kimconcillado/BeagleBone-CAN-Backpack/README.md

BeagleBone-CAN-Backpack
=======================

The BeagleBone CAN backpack plugs into a BeagleBone and provides a CAN transceiver and +12V power.
