kimconcillado/BeagleBone-CAN-Backpack/Beaglebone CAN Cape BOM.xlsx

Qty | Description | Category | Manufacturer | Manufacturer Part | Vendor | Vendor Part | Cost | Designator
1 | Header, .1", 2-row, 72-pos, breakable (Short Pins) | Connectors | TE Connectivity | 3-826925-6 | DK | A106443-ND | 5.23 | X3
1 | Micro-Fit header, 6pos, RA, through-hole, with metal retaining clip | Connectors | Molex | 43045-0621 | DK | WM2674-ND | 1.8 | X-343
1 | Header, Female socket, .1"", 1-row, 6-pos | Connectors | TE Connectivity | 534237-4 | DK | A26418-ND | 1.42 | SV1
4 | P-Channel Enhancement Mode Field-Effect Transistor, -0.13 A, -50 V, SOT-23 | Semiconductors | Fairchild Semiconductor | BSS84 | NW | 58K8770 | 0.03 | Q2, Q3, Q6, Q7
3 | Resistor, 4.7k ohm 1%, 100 mW, 100ppm, 0603 | Passives | Panasonic | ERJ-3EKF4701V | DK | P4.70KHCT-ND | 0.1 | R5, R6, R7
4 | N-channel MOSFET, 25V, 220 mA, SOT-23 | Semiconductors | Fairchild Semiconductor | FDV301N | NW | 58K8856 | 0.03 | Q9, Q10, Q11, Q12
1 | Capacitor, Ceramic, 10 uF 16V, 10%, X5R, 0805 | Passives | Murata | GRM21BR61C106KE15L | NW | 35R0687 | 0.2 | C11
1 | Resistor, 1k ohm 63 mW, 1%, 0603 | Passives | Multicomp | MC0603WGF1001T5E-TC | NW | 58K4448 | 500 | R13
2 | Capacitor, Ceramic, 22 uF, 6.3V, X5R, 20%, 0805 | 22 uF | Murata | GRM21BR60J226ME39L | NW | 24R6338 | 0.091 | C3, C4
1 | Connector, USB, MiniB. SMT RT | Connectors | TE Connectivity | 1734035-2 | DK | A31727CT-ND | 0.872 | X2
2 | Molex Dura-Clik Header, 2pos, Vertical, SMT | Connectors | Molex | 560020-0220 | DK | WM10862CT-ND | 0.82 | X-521, X-520
2 | Molex Dura-Clik header, 3pos, vertical, SMT | Connectors | Molex | 560020-0320 | DK | WM10863CT-ND | 0.91 | X-518, X-519
1 | IC, Memory, I2CEEPROM, SOIC-8 | ICs | ON Semiconductor | CAT24C256WI-GT3 | DK | CAT24C256WI-GT3OSCT-ND | 0.803 | CAT24C256WI-GT3
1 | IC, USB Serial, SSOP-28 | ICs | FTDI | FT232RL | DK | 768-1007-1-ND | 7.68 | IC3
1 | IC, DC-DC Conv, Buck, 42 Vin, 1.25 MHz, SOT23-6 | ICs | Texas Instruments | LMR14206XMKE/NOPB | NW | 76T5004 | 2.72 | IC1
1 | IC, LDO VOLT REG, 3.3V, 0.5A, SOT-223-5 | ICs | Texas Instruments | LP38693MP-3.3/NOPB | NW | 41K7496 | 1.53 | IC2
1 | IC, CAN TX/RX, 1 MBps, 5.5V, 8-SOIC | ICs | Texas Instruments | SN65HVD1050D | NW | 70K4439 | 1.32 | IC8
1 | Schottky rectifier, 30V, 1A, SMA | Passives | Diodes Inc | B130-13-F | DK | B130-FDICT-ND | 0.43 | D1
6 | Capacitor, Ceramic, .1uF 25V 10% 0603 X7R | Passives | TDK | C1608X7R1E104K080AA | DK | 445-1316-1-ND | 0.011 | C50, C2, C7, C8, C9, C10
1 | Choke, common mode, 100 uH, 500 mA, 25% | Passives | Bourns Inc | DR331-104AE | NW | 29T3649 | 0.32 | L6
1 | Resistor, 1 kohm 100 mW, 1%, Thick Film, 0603 | Passives | Panasonic | ERJ-3EKF1001V | NW | 64R5308 | 0.012 | R4
3 | Resistor, 5.6 kohm, 100 mW, 1%, 0603 | Passives | Panasonic | ERJ-3EKF5601V | NW | 64R5354 | 0.096 | R3, R8, R9
2 | Resistor, 60.4 ohm, 100 mW, 1%, 0603 | Passives | Panasonic | ERJ-3EKF60R4V | NW | 65T8495 | 0.096 | R38, R43
1 | Capacitor, Ceramic, 4.7 nF, 50V, X7R, 10%, 0603 | Passives | Murata | GRM188R71H472KA01D | NW | 38K1673 | 0.006 | C51
1 | Capacitor, Ceramic, 10UF, 35V, X5R, 10%, 1206 | Passives | Murata | GRM31CR6YA106KA12L | NW | 72R4211 | 0.355 | C6
1 | Capacitor, Ceramic, 1 uF, 50V, X7R, 10%, 1210 | Passives | Murata | GRM32RR71H105KA01L | NW | 97K0677 | 0.248 | C1
1 | Capacitor, Ceramic, 4.7 uF 25V, 10%, X5R, 0805 | Passives | Multicomp | MC0805X475K250CT | NW | 06R4181 | 0.037 | C5
1 | Diode, Zener, 3 V, 200 mW, SOD-323 | Passives | ON Semiconductor | MM3Z3V0T1G | NW | 09R9502 | 0.017 | D29
1 | Resistor, 36 kohm, 1%, 100 mW, 0603 | Passives | Yageo | RC0603FR-0736KL | DK | 311-36.0KHRCT-ND | 0.0108 | R19
9 | Resistor, 10k ohm 100 mW, 5%, 100ppm, 0603 | Passives | Yageo | RC0603JR-1010KL | NW | 68R0215 | 0.008 | R1, R2, R12, R14, R15, R16, R17, R18, R20
1 | Inductor, 18 uH, 1.5 A, unshielded, 15%, 8012 | Passives | Bourns | SDR0604-180YL | DK | SDR0604-180YLCT-ND | 0.47 | L1
2 | TVS DIODE 30VWM 48.4VC SMB | Passives | Littelfuse | SMBJ30CA | DK | SMBJ30CALFCT-ND | 0.423 | D6, D7
1 | Diode, Schottky, 40V, 500 mA, SOD-123 | Passives | STMICROELECTRONICS | STPS0560Z | NW | 89K1573 | 0.762 | D2
1 | DIP switch, 0.05"" pitch, 2pos, 50V | Switches | CTS Electrocomponents | 218-2LPST | DK | CT2182LPST-ND | 1.06 | SW2
