kimconcillado/BeagleBone-CAN-Backpack/Beaglebone CAN Cape schematic.pdf

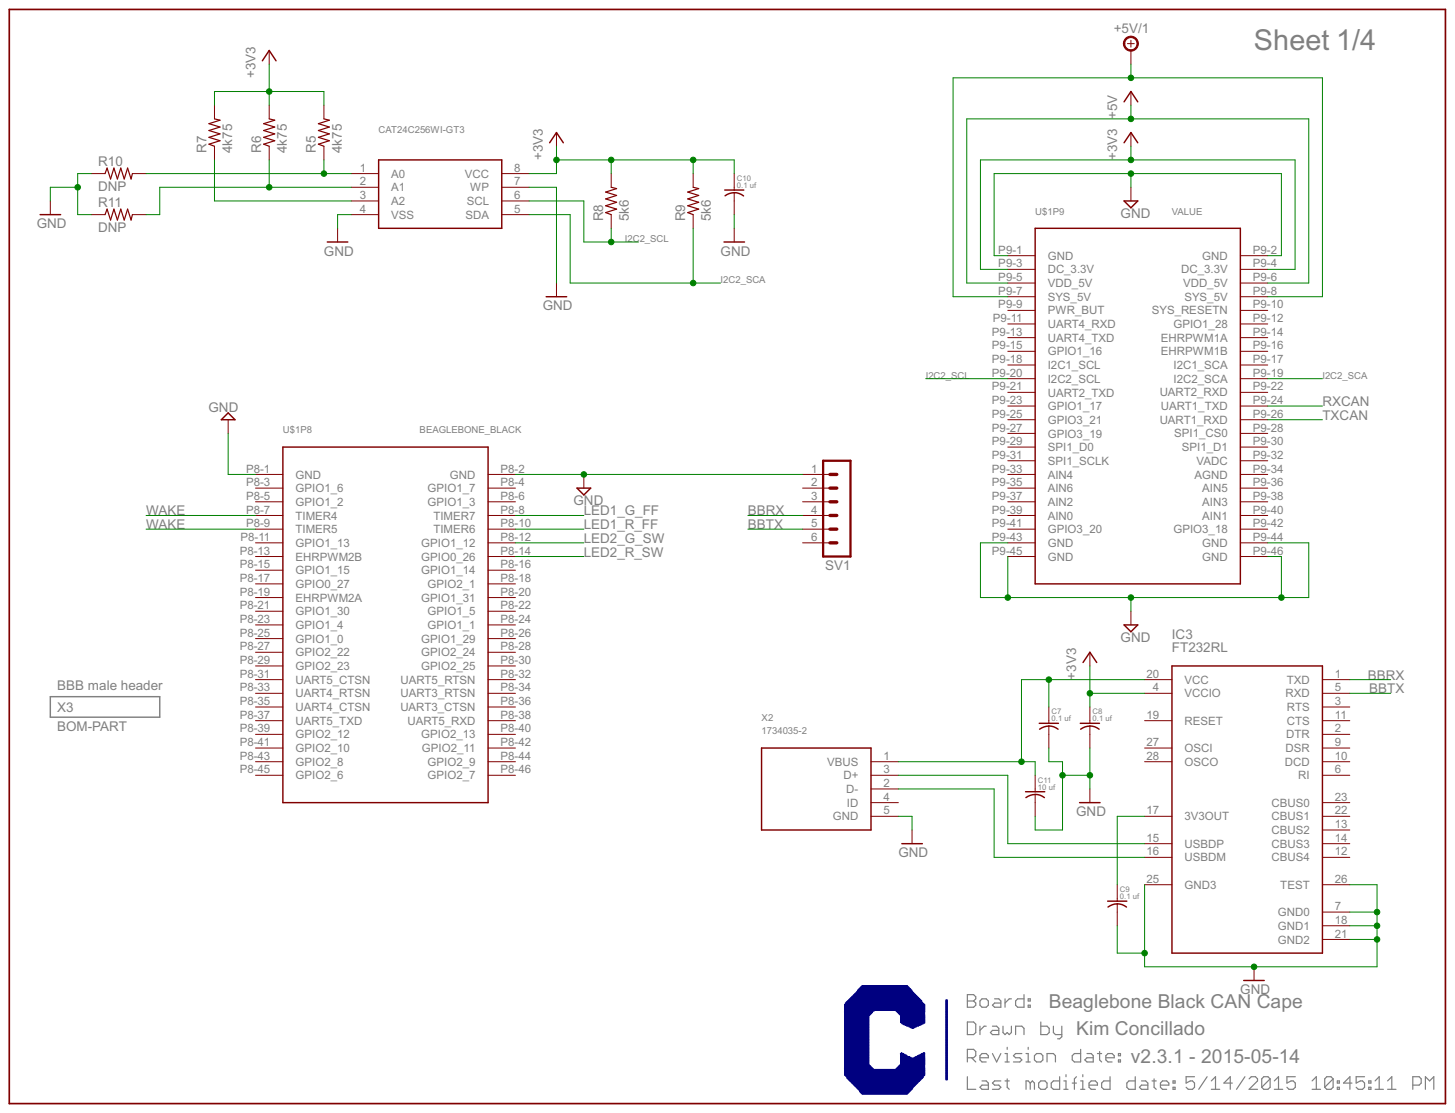
[picture p1: page 1]

Beaglebone Black CAN Cape
Kim Concillado

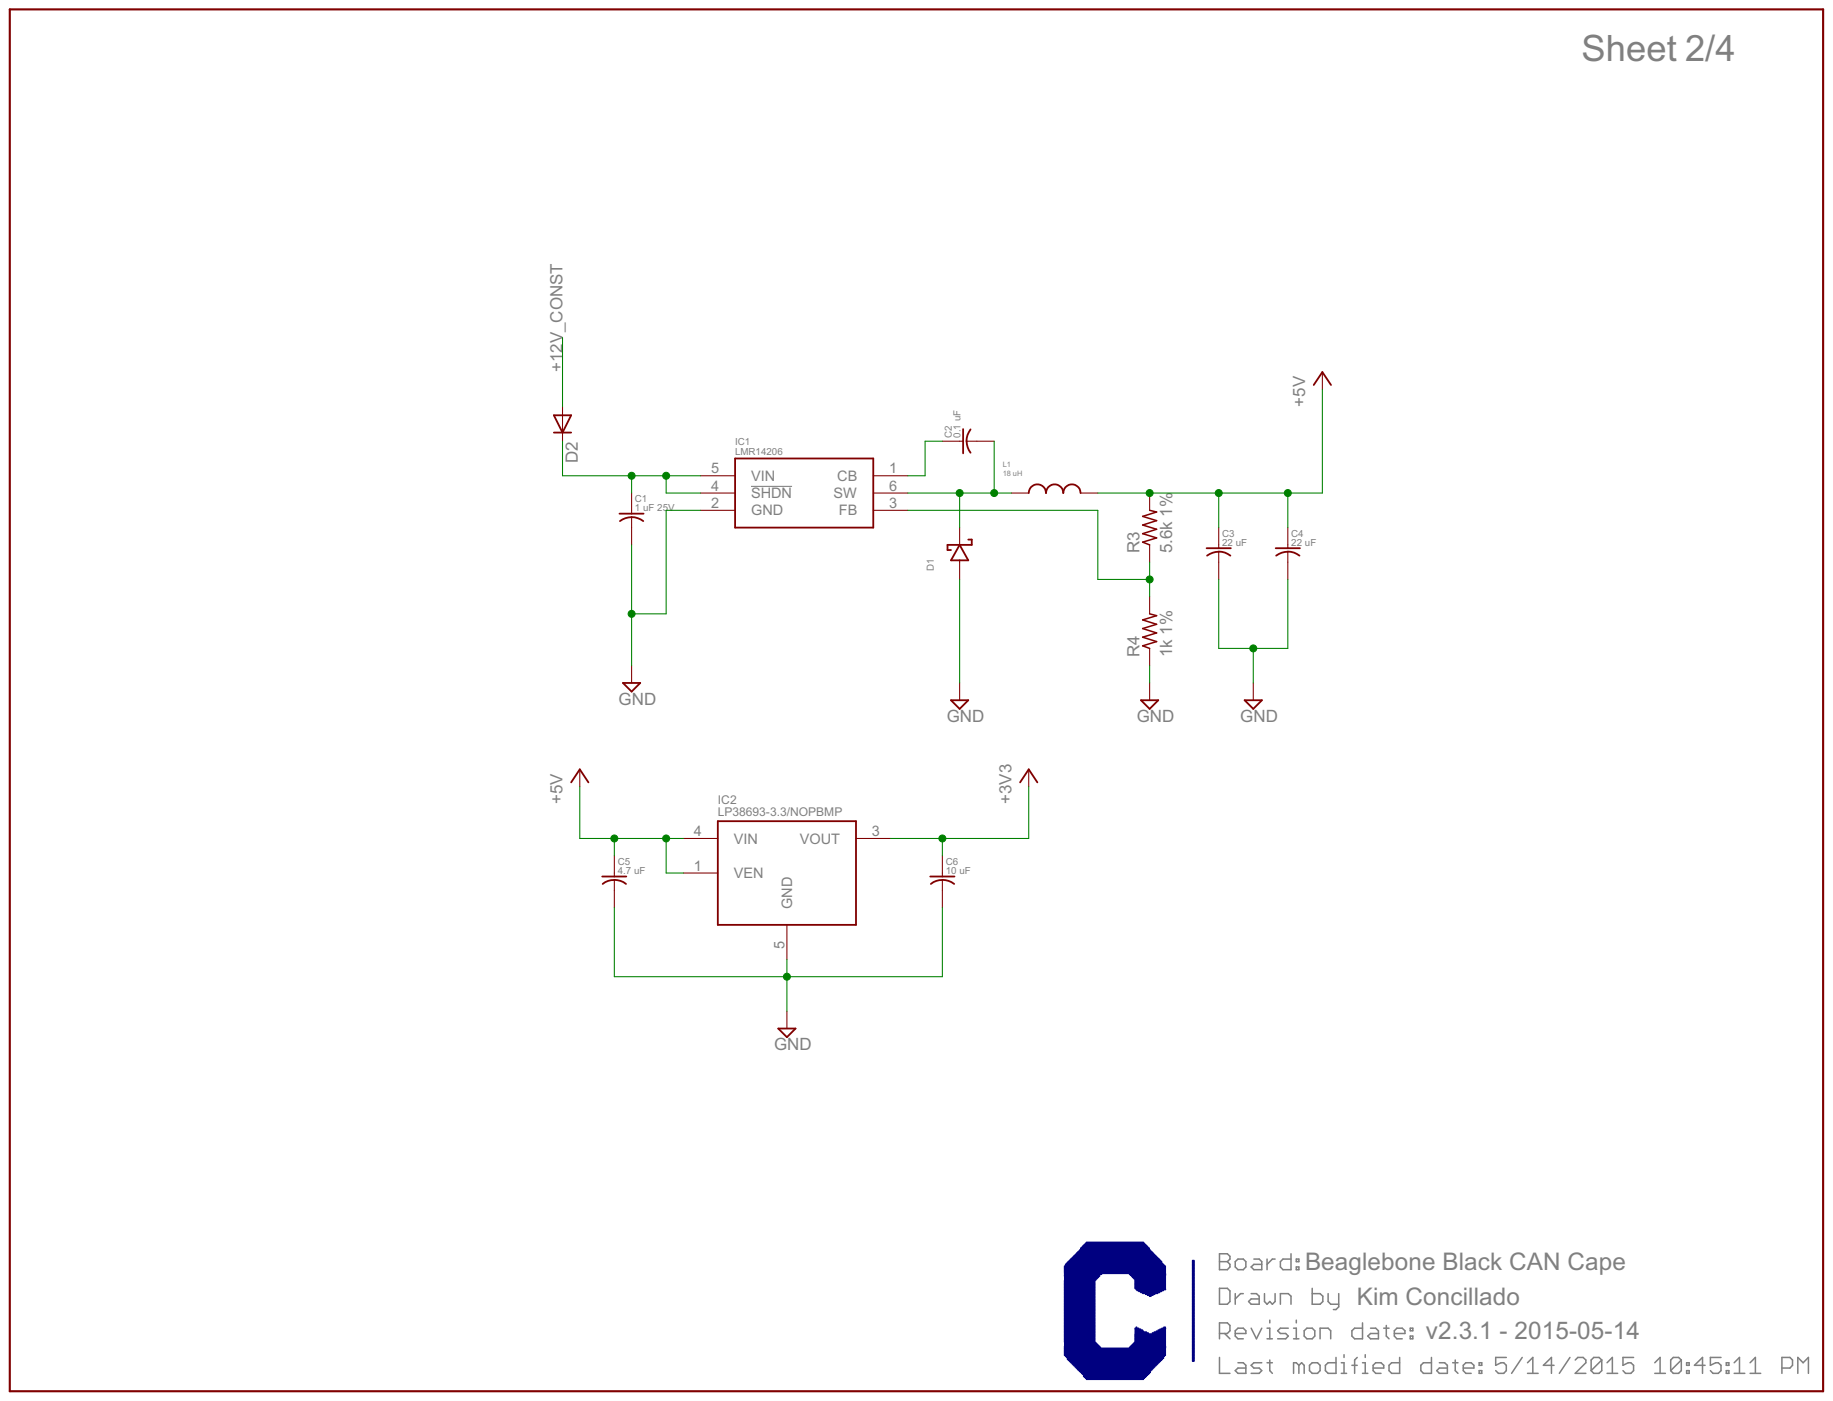
[picture p2: page 2]

Beaglebone Black CAN Cape
Kim Concillado

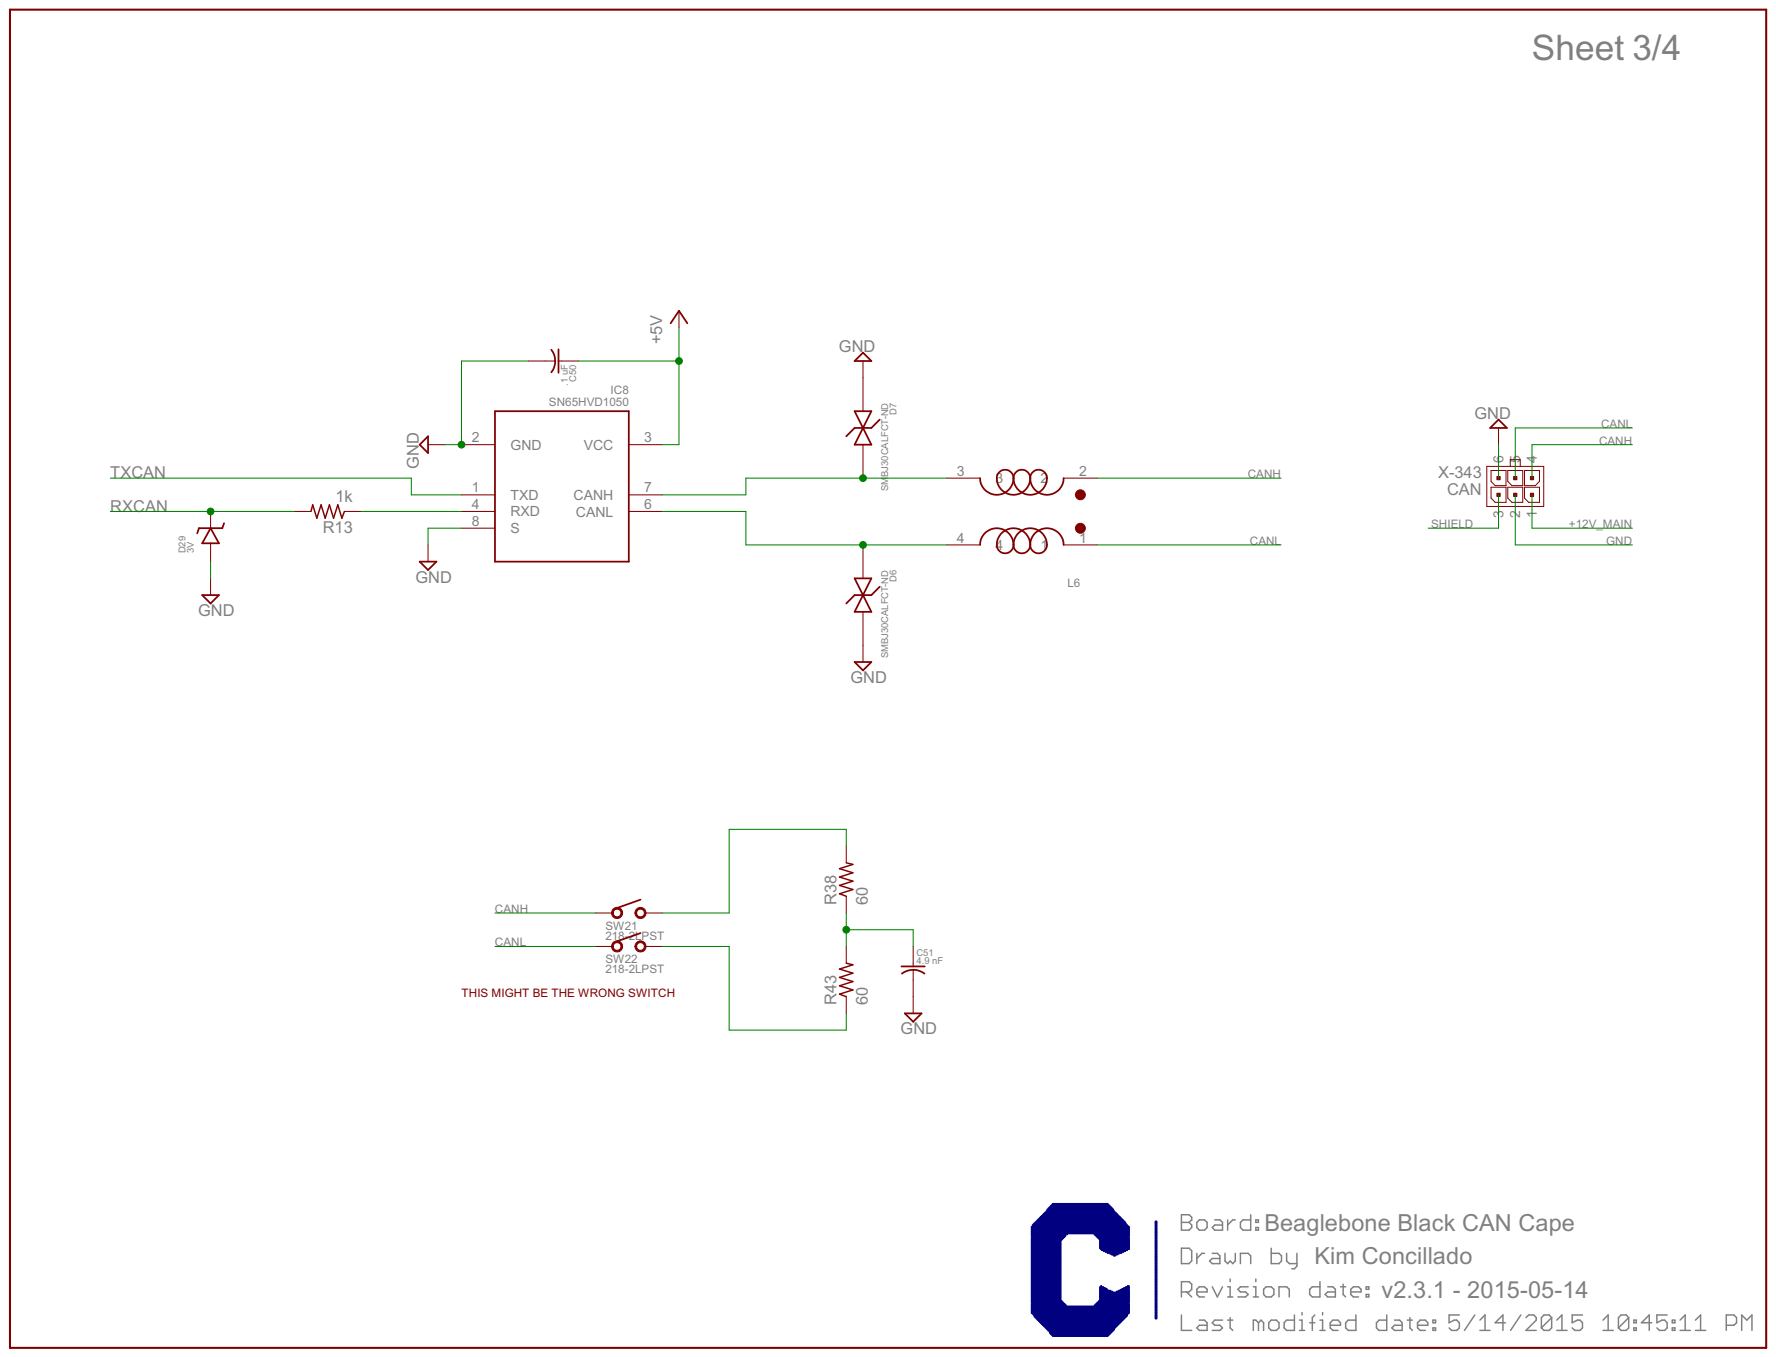
[picture p3: page 3]

THIS MIGHT BE THE WRONG SWITCH

Beaglebone Black CAN Cape
Kim Concillado

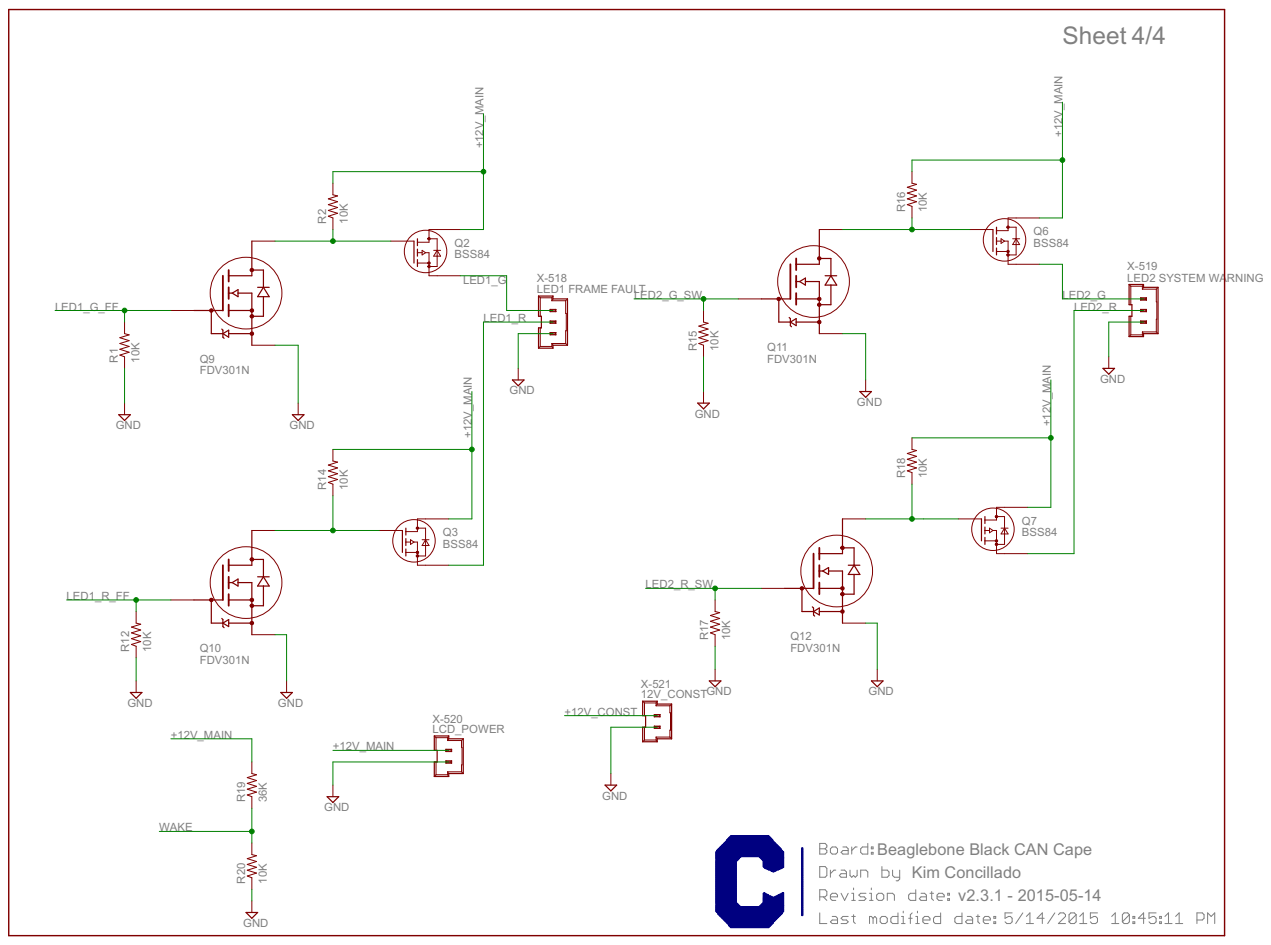
[picture p4: page 4]

Beaglebone Black CAN Cape
Kim Concillado
