kimconcillado/BeagleBone-CAN-Backpack/Beaglebone CAN Cape - bottom.pdf

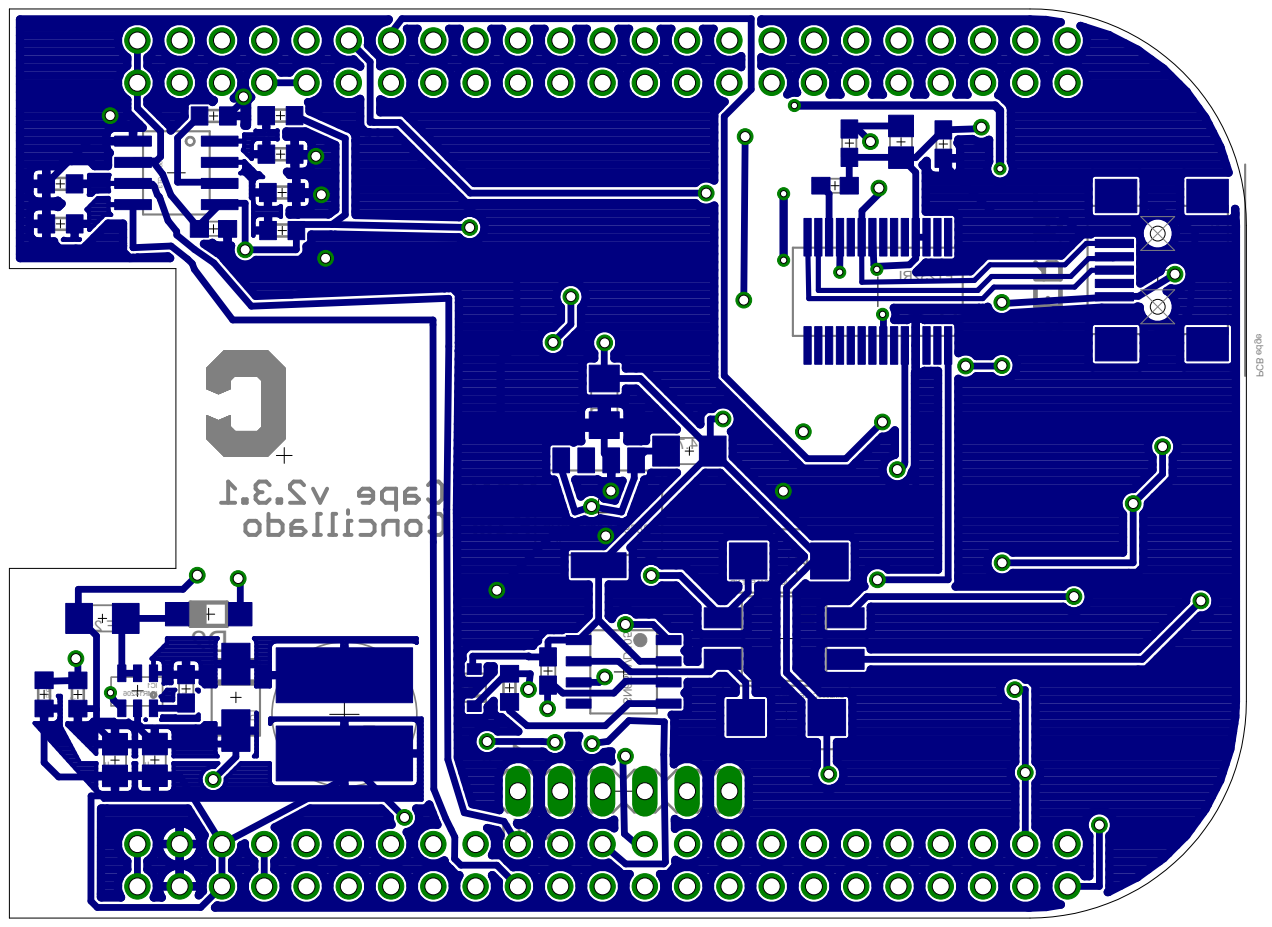
[picture p5: page 1]

LR232TF 2- 5304371 0.1 uf 0.1 uf f u 1. 0 10 uf f u 1. 0 57k4 57k4 57k4 6k5 6k5 PND PND 60241RML PMBPON/ 3. 3- 39683PL 5.6k 1% 1k 1% V52 Fu 1 0.1 uF 22 uF 22 uF18 uH Fu 7. 4 10 uF DN- TCFLAC03J BMS DN- TCFLAC03J BMS .1 uF SN65HVD1050 3V 1k 3CI 2X C7 C8 9C C11 01C 5R6R 7R 8R9R 01R 11R CAT24C256WI-GT3 1CI D1 2D 2CI R3 R4 1C C2 C3C4 L1 5C C6 6L 6D C7D 5 D0 29 R13 1VS PCB edge 1 6
