kimconcillado/BeagleBone-CAN-Backpack/Beaglebone CAN Cape - top.pdf

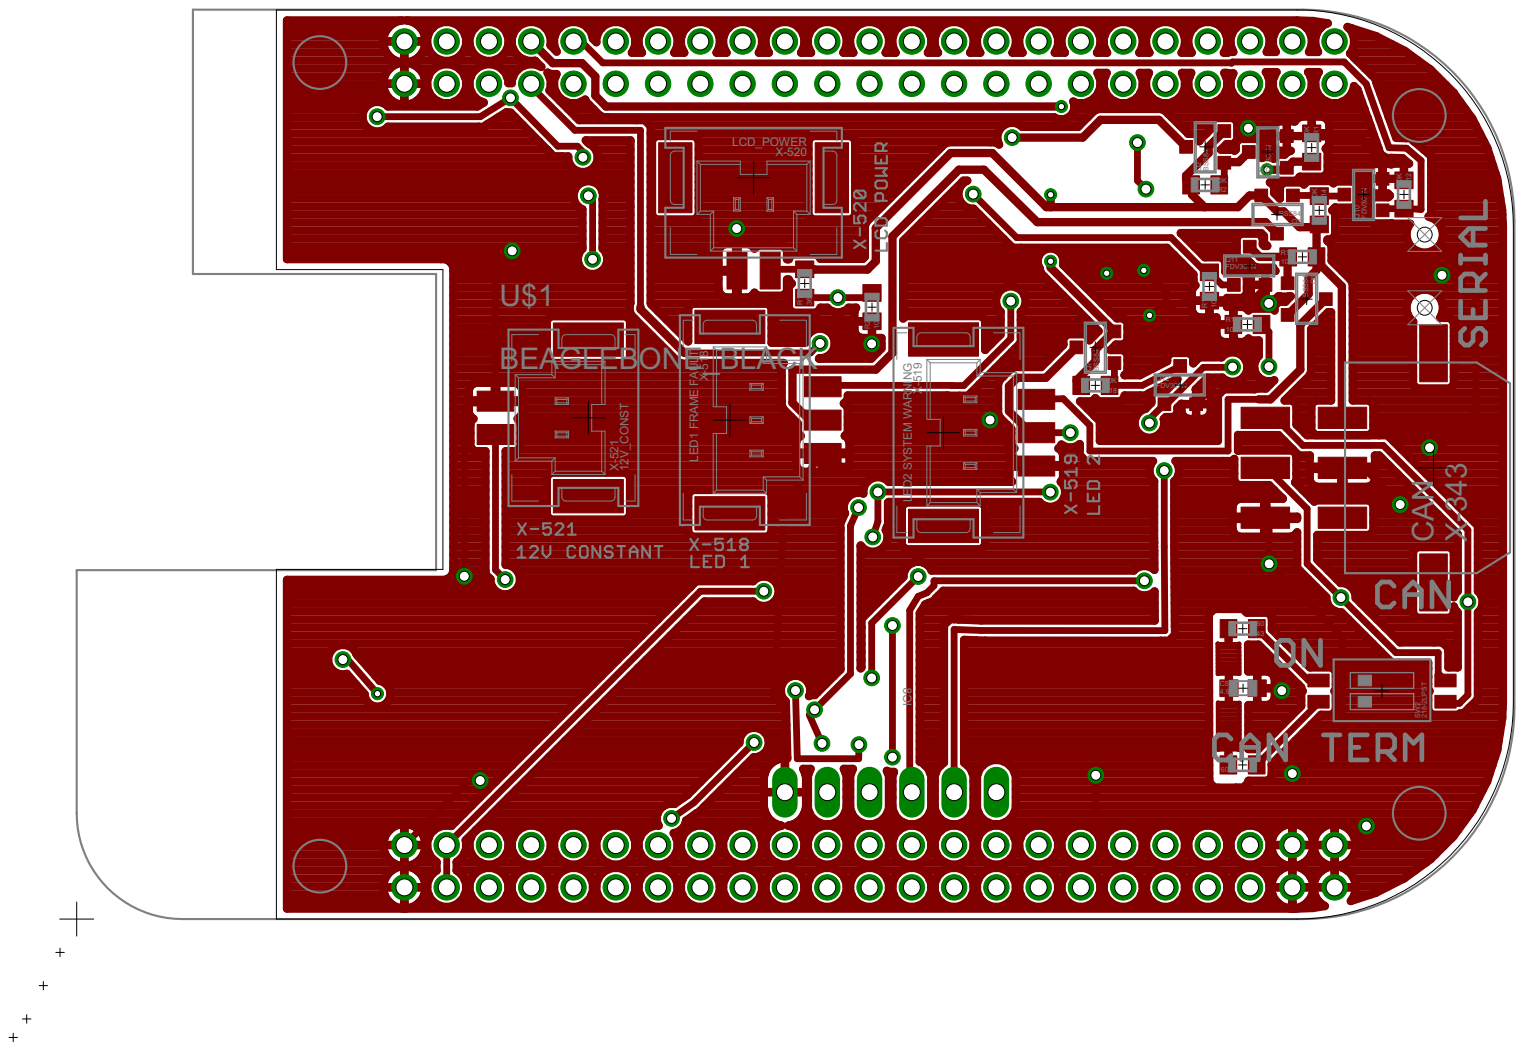
[picture p6: page 1]
