kimconcillado/BeagleBone-CAN-Backpack/(commit log)

2015-01-19 Move version 2.1 into GitHub
    [CAN Cape v2.1.brd, CAN Cape v2.1.sch, CAN Cape v2.1_BOM.xlsx, CAN_Cape2.0.SLDASM, CAN_Cape2.0_board.SLDPRT, TE_1-776276-1.SLDPRT, TE_1734035-2.SLDPRT, c-1-776276-1-c-3d.stp]
2015-01-25 Created schematic, removed files from last revision of board
    [Beaglebone CAN Cape.sch, CAN Cape v2.1.brd, CAN Cape v2.1.sch, CAN Cape v2.1_BOM.xlsx, CAN_Cape2.0.SLDASM, CAN_Cape2.0_board.SLDPRT, TE_1-776276-1.SLDPRT, TE_1734035-2.SLDPRT]
2015-02-03 Revert "Working changes for v2.2"
    [Beaglebone CAN Cape.sch, CAN Cape v2.1.brd, CAN Cape v2.1.sch, CAN Cape v2.1_BOM.xlsx, CAN_Cape2.0.SLDASM, CAN_Cape2.0_board.SLDPRT, TE_1-776276-1.SLDPRT, TE_1734035-2.SLDPRT]
2015-02-03 added ICs to schematic, began board arrangement
    [Beaglebone CAN Cape.brd, Beaglebone CAN Cape.sch]
2015-02-05 Arranged components on board, updated schematic with updated components
    [Beaglebone CAN Cape.brd, Beaglebone CAN Cape.sch]
2015-02-08 finished hooking up pads with routes/polygons/vias
    [Beaglebone CAN Cape.brd]
2015-02-10 edited board
    [Beaglebone CAN Cape.brd, Beaglebone CAN Cape.sch]
2015-02-11 More werk
    [Beaglebone CAN Cape.brd, Beaglebone CAN Cape.sch]
2015-02-12 Board is DRC approved, schematic is ERC approved
    [Beaglebone CAN Cape.brd]
2015-02-17 PUT LABELS ON IT, MADE A BOM
    [Beaglebone CAN Cape.brd, Beaglebone CAN Cape.sch]
2015-02-17 Added necessary documentation
    [Beaglebone CAN Cape BOM.xlsx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]
2015-02-25 RXCAN and TXCAN were switched per Jenn's suggested fix
    [Beaglebone CAN Cape.brd, Beaglebone CAN Cape.sch]
2015-02-25 recreated gerbers and sch pdf
2015-02-26 Approve rogue "Dimension" error on .brd (mechanical pad too near radius of board).
    [Beaglebone CAN Cape.brd]
2015-02-26 Add version number and revision date to schematic. Regenerate pdf files.
    [Beaglebone CAN Cape.sch]
2015-03-27 Resolved Issue #8 Duplicate lines in BOM
    [Beaglebone CAN Cape BOM.xlsx, Beaglebone CAN Cape.brd, Beaglebone CAN Cape.sch]
2015-03-27 Resolved Issue #10 USB connection pinout error
    [Beaglebone CAN Cape.brd, Beaglebone CAN Cape.sch]
2015-03-30 Resolved issue #10 USB pinout error by updating Components library
    [Beaglebone CAN Cape.brd, Beaglebone CAN Cape.sch]
2015-03-31 Preliminary LED driver circuit implemented for issue #13 Add LED driver circuit for front panel indicator LEDs
    [Beaglebone CAN Cape.brd, Beaglebone CAN Cape.sch]
2015-04-02 Named nets and connected to pins for issue #13
    [Beaglebone CAN Cape.brd, Beaglebone CAN Cape.sch]
2015-04-02 Added connector for issue #15
    [Beaglebone CAN Cape.brd, Beaglebone CAN Cape.sch]
2015-04-02 Added power circuit for #14
    [Beaglebone CAN Cape.brd, Beaglebone CAN Cape.sch]
2015-04-04 Passes DRC (as long as polygon width errors are neglegible) and ERC
    [Beaglebone CAN Cape.brd, Beaglebone CAN Cape.sch]
2015-04-04 Commit containing changes from Aaron and Sean. Still have to :change wake signal to GPIO set 0, name connectors, rename pin nets connected to LEDs , label connectors
    [Beaglebone CAN Cape.brd, Beaglebone CAN Cape.sch]
2015-04-06 BOM created, passes ERC and DRC
    [Beaglebone CAN Cape BOM.xlsx, Beaglebone CAN Cape.brd, Beaglebone CAN Cape.sch]
2015-04-06 Made PDFs
    [Beaglebone CAN Cape.brd, Beaglebone CAN Cape.sch]
2015-04-06 Completed BOM with categories and unit price
    [Beaglebone CAN Cape BOM.xlsx]
2015-04-06 Gerbers created BITCH
    [Board Outline.GKO, Bottom Layer.GBL, Bottom Silk Screen.GBO, Bottom Solder Mask.GBS, Drills.XLN, Top Layer.GTL, Top Silk Screen.GTO, Top Solder Mask.GTS]
2015-04-07 Add version number to sch. Update connector labeling from Molex.lbr. Regenerate PDFs.
    [Beaglebone CAN Cape.brd, Beaglebone CAN Cape.sch]
2015-05-13 TX and RX CAN lines are routed, Unrouted layer is on
    [Beaglebone CAN Cape.brd, Beaglebone CAN Cape.sch]
2015-05-14 rerouted new pins for LEDs, check out shaky DRC because coffee shop is closing and I have to go
    [Beaglebone CAN Cape.brd, Beaglebone CAN Cape.sch]
2015-05-15 Update with corrected transistor packages from Component-libraries. Correct board layout to reflect updated footprints.
    [Beaglebone CAN Cape.brd, Beaglebone CAN Cape.sch]
2015-05-15 Resolve DRC errors
    [Beaglebone CAN Cape.brd]
2015-05-15 Bump version number to v2.3.1; regenerate Gerbers/PDFs
    [Beaglebone CAN Cape.brd, Beaglebone CAN Cape.sch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]
2015-05-15 Ignore Gerber junk
2015-05-15 Can't figure out how to merge/pull stuff from Github to PC so I'm creating new gerbers for myself
    [Beaglebone CAN Cape.brd, Beaglebone CAN Cape.sch]
